wagiminator/ATtiny85-TinyTerminal/hardware/TinyTerminal_BOM.tsv

ID | Name | Designator | Footprint | Quantity | Manufacturer Part | Manufacturer | Supplier | Supplier Part | LCSC Assembly
1 | MMBT3904 | Q1 | SOT-23_1 | 1 | 2n3904S-RTK/PS | KEC | LCSC | C18536
2 | MLT-5030 | BUZZER | MLT-5030 | 1 | MLT-5030 | HNDZ | LCSC | C95297
3 | 3V6 | D2,D1 | ZENER-SOD-123 | 2 | BZT52C3V6 | (MDD) Jiangsu Yutai Elec | LCSC | C173412 | Yes
4 | OLED | J2 | I2C OLED 0.96 NEW | 1 | SSD1306 I2C OLED
5 | 68R | R3,R2 | 0603 | 2 | 0603WAF680JT5E | UniOhm | LCSC | C27592
6 | 1k5 | R4,R7 | 0603 | 2 | 0603WAF1501T5E | UniOhm | LCSC | C22843
7 | 10k | R1,R6,R5 | 0603 | 3 | 0603WAF1002T5E | UniOhm | LCSC | C25804
8 | ATtiny85 | U1 | SOIC-8_208MIL | 1 | ATTINY85-20SU | MICROCHIP | LCSC | C89852
9 | ICSP | J1 | ICSP-6 | 1 | ?
10 | 100n | C1 | 0603 | 1 | CC0603KRX7R9BB104 | YAGEO | LCSC | C14663
11 | 47u | C2 | 1206 | 1 | CL31A476MQHNNNE | SAMSUNG | LCSC | C68361
12 | Micro USB | USB1 | MICRO-USB-16 | 1 | - | Boom Precision Elec | LCSC | C21377
