wagiminator/ATtiny85-TinyTerminal/hardware/TinyTerminal_schematic.pdf

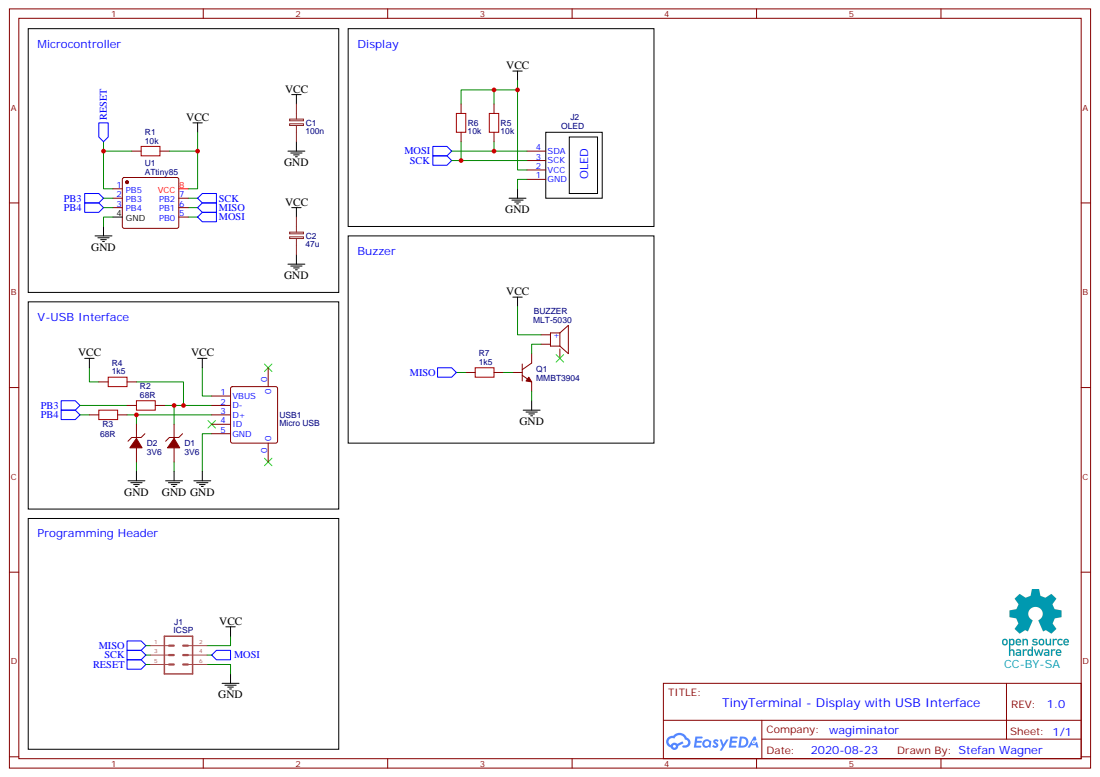
[picture p4: page 1]

Drawn By: Stefan Wagner
